jmansmann/ManualTransmissionTrainer/Manual Transmission Trainer/Manual Transmission Trainer Files/Hardware/image1.jpeg

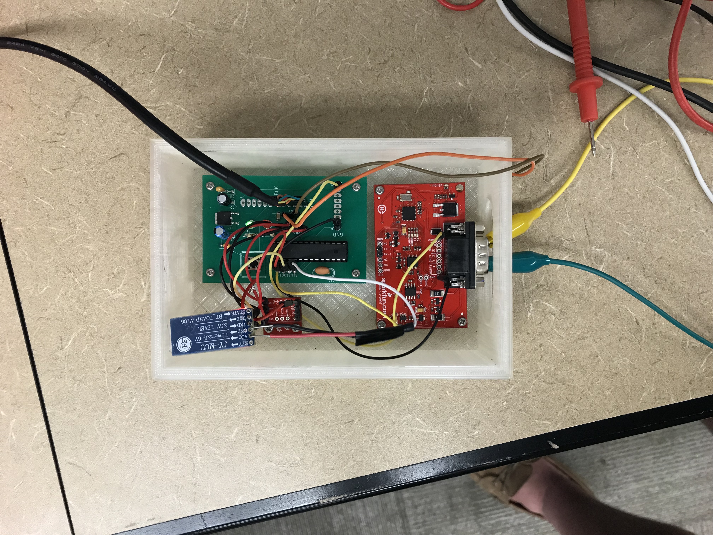
Manual Transmission Trainer/Manual Transmission Trainer Files/Hardware/image1.jpeg
