jmansmann/ManualTransmissionTrainer/Manual Transmission Trainer/Manual Transmission Trainer Files/Hardware/image2.jpeg

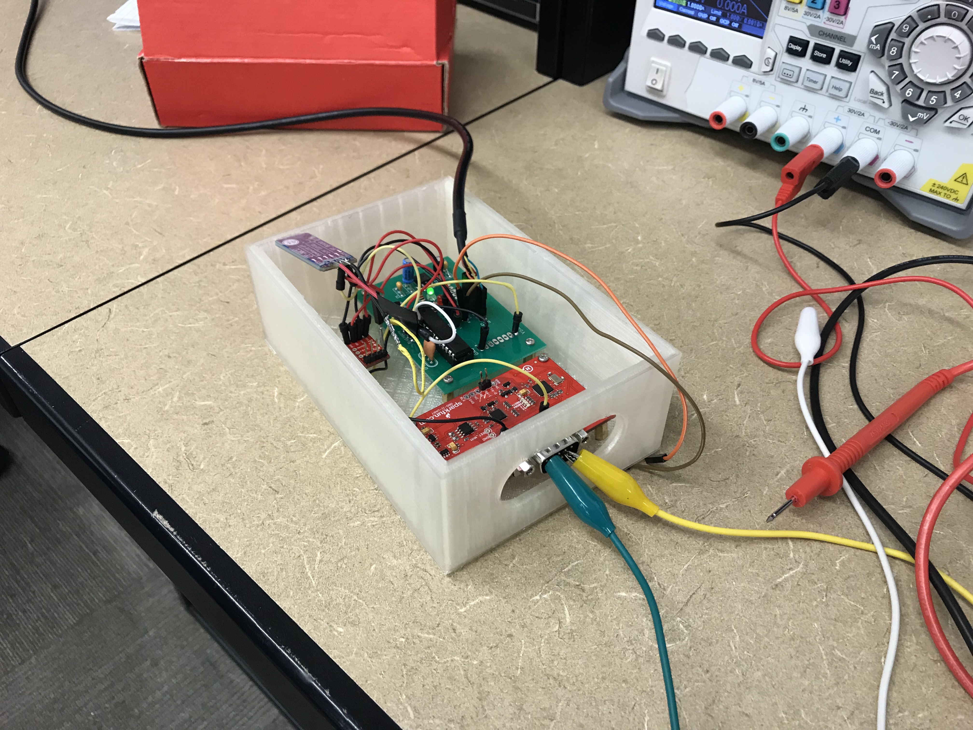
Manual Transmission Trainer/Manual Transmission Trainer Files/Hardware/image2.jpeg
