jmansmann/ManualTransmissionTrainer/Manual Transmission Trainer/Manual Transmission Trainer Files/Software/README.txt

Boarduino Read - Code associated with C++ application
Final_Arduino - Code associated with reading data from the microprocessor
Java - Source code for the entire Java application
Data - All types of the types of files that were used in testing and training the tree
