jmansmann/ManualTransmissionTrainer/Manual Transmission Trainer/Manual Transmission Trainer Files/Hardware/main_box.STL

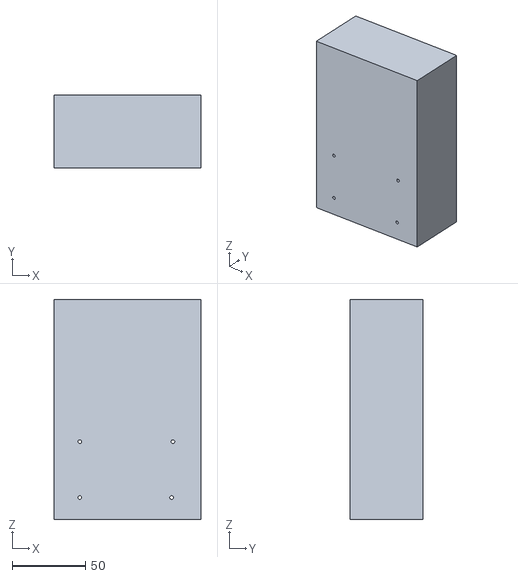
[picture p3: CAD file, 2019-01-07]
Manual Transmission Trainer/Manual Transmission Trainer Files/Hardware/main_box.STL
100.0 x 50.0 x 150.0
