jmansmann/ManualTransmissionTrainer/Manual Transmission Trainer/Manual Transmission Trainer Files/Hardware/mtt_housing_lid.STL

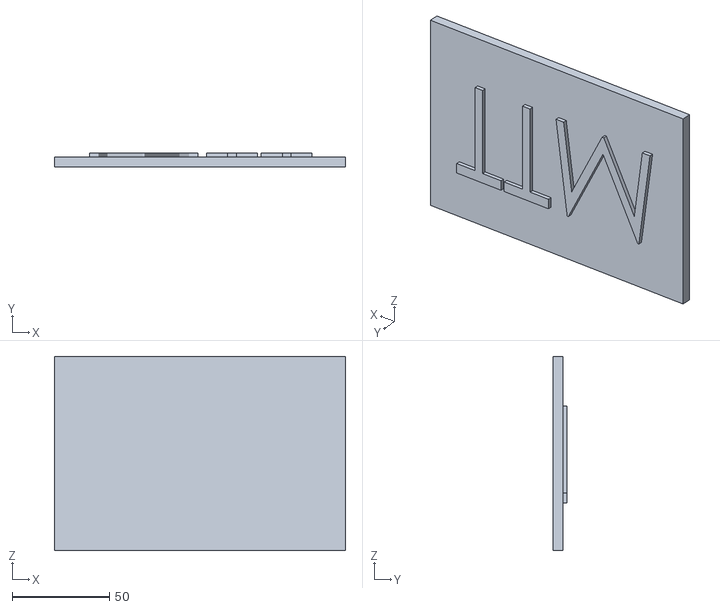
[picture p4: CAD file, 2019-01-07]
Manual Transmission Trainer/Manual Transmission Trainer Files/Hardware/mtt_housing_lid.STL
150.0 x 7.00 x 100.0
