jmansmann/ManualTransmissionTrainer/Manual Transmission Trainer/Manual Transmission Trainer Files/Software/Boarduino Read/README.txt

ArduinoRead.cpp  - Source C++ code to read from the bluetooth and commnicate with Java Program
BoarduinoRead.dev - Project File for the C++ console application
BoarduinoRead.exe - Exectable C++ console application
SerialPort.cpp - Sample Source code to real from a serial COM port
SerialPort.h - header file that goes with SerialPort.cpp
Makefile.win, BoarduinoRead.layout - default files that assist in project creation
*.o - object files
