jmansmann/ManualTransmissionTrainer/Manual Transmission Trainer/Manual Transmission Trainer Files/Software/Final_Arduino/README.txt

Final_Arduino  - Source code that reads data from car and sends that data over the Bluetooth
MPU9250.cpp - Code from internet used to operate MPU9250 gyroscope correctly
MPU9250.h - header file for MPU9250.cpp
quaternionFilters.cpp - Code from internet used to help operate the gyroscope
quaternionFilters.h - header file for quaternionFilters.cpp
