jmansmann/ManualTransmissionTrainer/Manual Transmission Trainer/Manual Transmission Trainer Files/Software/Data/6th_geaer_no_load.png

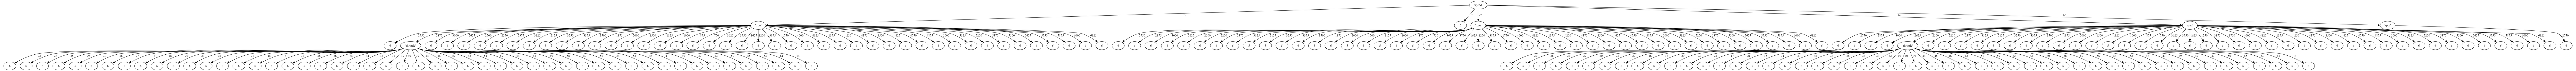
Manual Transmission Trainer/Manual Transmission Trainer Files/Software/Data/6th_geaer_no_load.png
