jmansmann/ManualTransmissionTrainer/Manual Transmission Trainer/Manual Transmission Trainer Files/Software/Data/6th_gear_tree.png

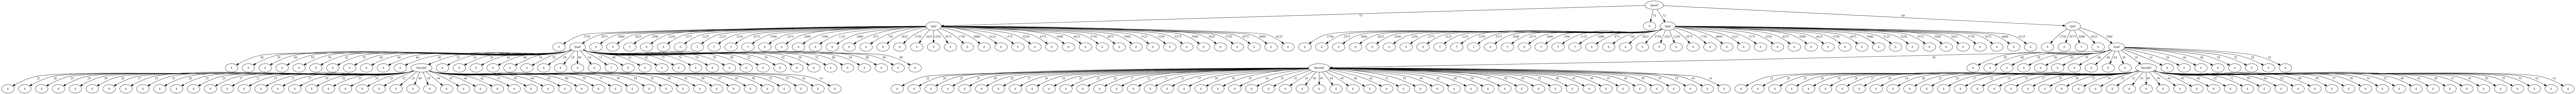
Manual Transmission Trainer/Manual Transmission Trainer Files/Software/Data/6th_gear_tree.png
