jmansmann/ManualTransmissionTrainer/Manual Transmission Trainer/Manual Transmission Trainer Files/Software/Data/OBDWiz files/First Gear/first_for_test.csv

# StartTime = 07/20/2018 02:20:26.3640 PM
Time (sec) | Vehicle speed (MPH) | Engine RPM (RPM) | Absolute throttle position (%) | Absolute load value (%) | MPH | RPM | Throttle | Load
0 | 0 | 0 | 0 | 0
0.06 | 0 | 2071 | 18.03922 | 0
0.126 | 10.56331 | 2071 | 18.03922 | 24.31373 | 12 | 2125 | 18 | 24
0.185 | 10.56331 | 2071 | 18.03922 | 24.31373 | 12 | 2125 | 18 | 24
0.251 | 10.56331 | 2102 | 18.03922 | 24.31373 | 12 | 2125 | 18 | 24
0.31 | 10.56331 | 2102 | 18.43137 | 24.70588 | 12 | 2125 | 18 | 24
0.375 | 10.56331 | 2102 | 18.43137 | 24.70588 | 12 | 2125 | 18 | 24
0.435 | 10.56331 | 2147 | 18.43137 | 24.70588 | 12 | 2125 | 18 | 24
0.503 | 10.56331 | 2147 | 18.43137 | 24.70588 | 12 | 2125 | 18 | 24
0.563 | 10.56331 | 2147 | 18.43137 | 24.70588 | 12 | 2125 | 18 | 24
0.623 | 10.56331 | 2147 | 18.43137 | 24.70588 | 12 | 2125 | 18 | 24
0.685 | 10.56331 | 2175 | 18.43137 | 24.70588 | 12 | 2125 | 18 | 24
0.753 | 10.56331 | 2175 | 18.43137 | 24.31373 | 12 | 2125 | 18 | 24
0.813 | 10.56331 | 2175 | 18.43137 | 24.31373 | 12 | 2125 | 18 | 24
0.873 | 10.56331 | 2228 | 18.43137 | 24.31373 | 12 | 2250 | 18 | 24
0.935 | 10.56331 | 2228 | 18.03922 | 23.13725 | 12 | 2250 | 18 | 24
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
