jmansmann/ManualTransmissionTrainer/Manual Transmission Trainer/Manual Transmission Trainer Files/Software/Data/OBDWiz files/Fourth Gear/fourth_for_test.csv

# StartTime = 08/01/2018 06:17:32.2497 PM
Time (sec) | Vehicle speed (MPH) | Engine RPM (RPM) | Absolute throttle position (%) | Absolute load value (%)
0 | 0 | 0 | 0 | 0
0.734 | 35.41816 | 1997 | 18.82353 | 50.58823
0.95 | 36.03953 | 2024 | 20.78431 | 28.62745
1.166 | 36.03953 | 2056 | 22.7451 | 40
1.373 | 36.6609 | 2089 | 21.96078 | 55.29412
1.582 | 37.28227 | 2107 | 21.96078 | 47.45098
1.794 | 37.90364 | 2146 | 21.96078 | 49.41177
2.018 | 38.52501 | 2183 | 21.56863 | 48.62745
2.234 | 39.14639 | 2192 | 16.47059 | 49.01961
2.458 | 39.14639 | 2219 | 16.07843 | 14.90196
2.67 | 39.76776 | 2231 | 14.90196 | 14.90196
2.891 | 39.76776 | 2220 | 15.29412 | 13.72549
3.107 | 40.38913 | 2242 | 15.29412 | 10.58823
3.33 | 39.76776 | 2254 | 15.29412 | 10.58823
3.542 | 40.38913 | 2264 | 15.29412 | 10.58823
3.762 | 40.38913 | 2263 | 17.64706 | 10.58823
3.979 | 40.38913 | 2298 | 17.2549 | 14.11765
4.203 | 40.38913 | 2271 | 16.07843 | 14.5098
4.415 | 40.38913 | 2276 | 15.68627 | 14.5098
4.635 | 40.38913 | 2285 | 16.47059 | 12.15686
4.851 | 41.0105 | 2290 | 18.03922 | 11.76471
5.067 | 41.0105 | 2304 | 18.43137 | 17.64706
5.267 | 41.0105 | 2302 | 14.90196 | 22.35294
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
