jmansmann/ManualTransmissionTrainer/Manual Transmission Trainer/Manual Transmission Trainer Files/Software/Data/OBDWiz files/Second Gear/second_for_test.csv

# StartTime = 07/20/2018 02:19:10.7379 PM
Time (sec) | Vehicle speed (MPH) | Engine RPM (RPM) | Absolute throttle position (%) | Absolute load value (%)
0 | 11.80605 | 0 | 0 | 0 | 12 | 0 | 0 | 0
0.062 | 11.80605 | 0 | 0 | 0 | 12 | 0 | 0 | 0
0.13 | 11.80605 | 0 | 0 | 0 | 12 | 0 | 0 | 0
0.186 | 11.80605 | 0 | 0 | 0 | 12 | 0 | 0 | 0
0.251 | 11.80605 | 0 | 0 | 0 | 12 | 0 | 0 | 0
0.311 | 11.80605 | 0 | 0 | 0 | 12 | 0 | 0 | 0
0.379 | 11.80605 | 0 | 0 | 0 | 12 | 0 | 0 | 0
0.439 | 11.80605 | 0 | 0 | 0 | 12 | 0 | 0 | 0
0.499 | 11.80605 | 0 | 0 | 0 | 12 | 0 | 0 | 0
0.562 | 11.80605 | 0 | 0 | 0 | 12 | 0 | 0 | 0
0.63 | 11.80605 | 0 | 0 | 0 | 12 | 0 | 0 | 0
0.689 | 11.80605 | 0 | 0 | 0 | 12 | 0 | 0 | 0
0.75 | 12.42742 | 1556 | 24.31373 | 77.25491 | 12 | 1500 | 24 | 78
0.813 | 14.91291 | 1556 | 24.31373 | 77.25491 | 15 | 1500 | 24 | 78
0.874 | 14.91291 | 1556 | 24.31373 | 77.25491 | 15 | 1500 | 24 | 78
0.937 | 14.91291 | 1729 | 26.27451 | 77.25491 | 15 | 1750 | 26 | 78
1.001 | 15.53428 | 1729 | 26.27451 | 67.84314 | 15 | 1750 | 26 | 68
1.061 | 15.53428 | 1729 | 26.27451 | 67.84314 | 15 | 1750 | 26 | 68
1.129 | 15.53428 | 1831 | 26.66667 | 67.84314 | 15 | 1875 | 27 | 68
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
