jmansmann/ManualTransmissionTrainer/Manual Transmission Trainer/Manual Transmission Trainer Files/Software/Data/OBDWiz files/Sixth Gear/sixth_for_test.csv

# StartTime = 07/20/2018 02:01:32.8629 PM
Time (sec) | Vehicle speed (MPH) | Engine RPM (RPM) | Absolute throttle position (%) | Absolute load value (%) | MPH | RPM | Throttle | Load
0 | 0 | 2467 | 0 | 0
0.064 | 0 | 2467 | 22.35294 | 45.88235
0.125 | 65.86535 | 2467 | 22.35294 | 45.88235 | 66 | 2500 | 22 | 46
0.186 | 65.86535 | 2471 | 22.35294 | 45.88235 | 66 | 2500 | 22 | 46
0.254 | 65.86535 | 2471 | 22.35294 | 45.4902 | 66 | 2500 | 22 | 46
0.314 | 65.86535 | 2471 | 22.35294 | 45.4902 | 66 | 2500 | 22 | 46
0.375 | 65.86535 | 2471 | 22.35294 | 45.4902 | 66 | 2500 | 22 | 46
0.436 | 65.86535 | 2477 | 22.35294 | 45.4902 | 66 | 2500 | 22 | 46
0.504 | 65.86535 | 2477 | 22.35294 | 46.66667 | 66 | 2500 | 22 | 46
0.563 | 65.86535 | 2477 | 22.35294 | 46.66667 | 66 | 2500 | 22 | 46
0.623 | 65.86535 | 2481 | 22.35294 | 46.66667 | 66 | 2500 | 22 | 46
0.686 | 65.86535 | 2481 | 21.56863 | 45.4902 | 66 | 2500 | 22 | 46
0.754 | 65.86535 | 2481 | 21.56863 | 45.4902 | 66 | 2500 | 22 | 46
0.814 | 65.86535 | 2481 | 21.56863 | 45.4902 | 66 | 2500 | 22 | 46
0.874 | 65.86535 | 2486 | 20.39216 | 45.4902 | 66 | 2500 | 20 | 46
0.937 | 66.48672 | 2486 | 20.39216 | 34.5098 | 66 | 2500 | 20 | 34
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
