jmansmann/ManualTransmissionTrainer/Manual Transmission Trainer/Manual Transmission Trainer Files/Software/Data/OBDWiz files/Third Gear/third_for_test.csv

# StartTime = 08/01/2018 06:14:46.4162 PM
Time (sec) | Vehicle speed (MPH) | Engine RPM (RPM) | Absolute throttle position (%) | Absolute load value (%)
0 | 21.74799 | 1669 | 19.60784 | 0
0.212 | 22.36936 | 1683 | 19.60784 | 42.35294
0.424 | 22.36936 | 1700 | 19.60784 | 42.35294
0.636 | 22.99073 | 1714 | 19.60784 | 41.96078
0.852 | 22.99073 | 1731 | 20 | 42.7451
1.072 | 22.99073 | 1762 | 26.66667 | 67.45098
1.288 | 24.23348 | 1799 | 27.05882 | 67.45098
1.504 | 24.23348 | 1837 | 27.05882 | 69.01961
1.717 | 24.85485 | 1878 | 27.45098 | 69.01961
1.936 | 25.47622 | 1915 | 27.45098 | 69.41177
2.141 | 25.47622 | 1943 | 27.45098 | 68.62745
2.349 | 26.09759 | 1978 | 27.45098 | 69.80392
2.559 | 26.71896 | 2024 | 27.45098 | 70.58823
2.783 | 27.34033 | 2070 | 27.45098 | 67.84314
3.003 | 27.9617 | 2105 | 27.84314 | 69.01961
3.223 | 28.58307 | 2150 | 27.84314 | 69.41177
3.439 | 29.20445 | 2191 | 27.84314 | 69.80392
3.643 | 29.20445 | 2233 | 27.84314 | 70.19608
3.855 | 29.82582 | 2266 | 27.45098 | 69.01961
4.071 | 30.44719 | 2292 | 27.05882 | 66.27451
4.287 | 31.06856 | 2323 | 26.27451 | 66.66666
4.503 | 31.68993 | 2363 | 25.4902 | 66.27451
4.719 | 31.68993 | 2404 | 25.4902 | 62.7451
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
