jmansmann/ManualTransmissionTrainer/Manual Transmission Trainer/Manual Transmission Trainer Files/Software/Data/real-time test files/RealDataScreenShot.PNG

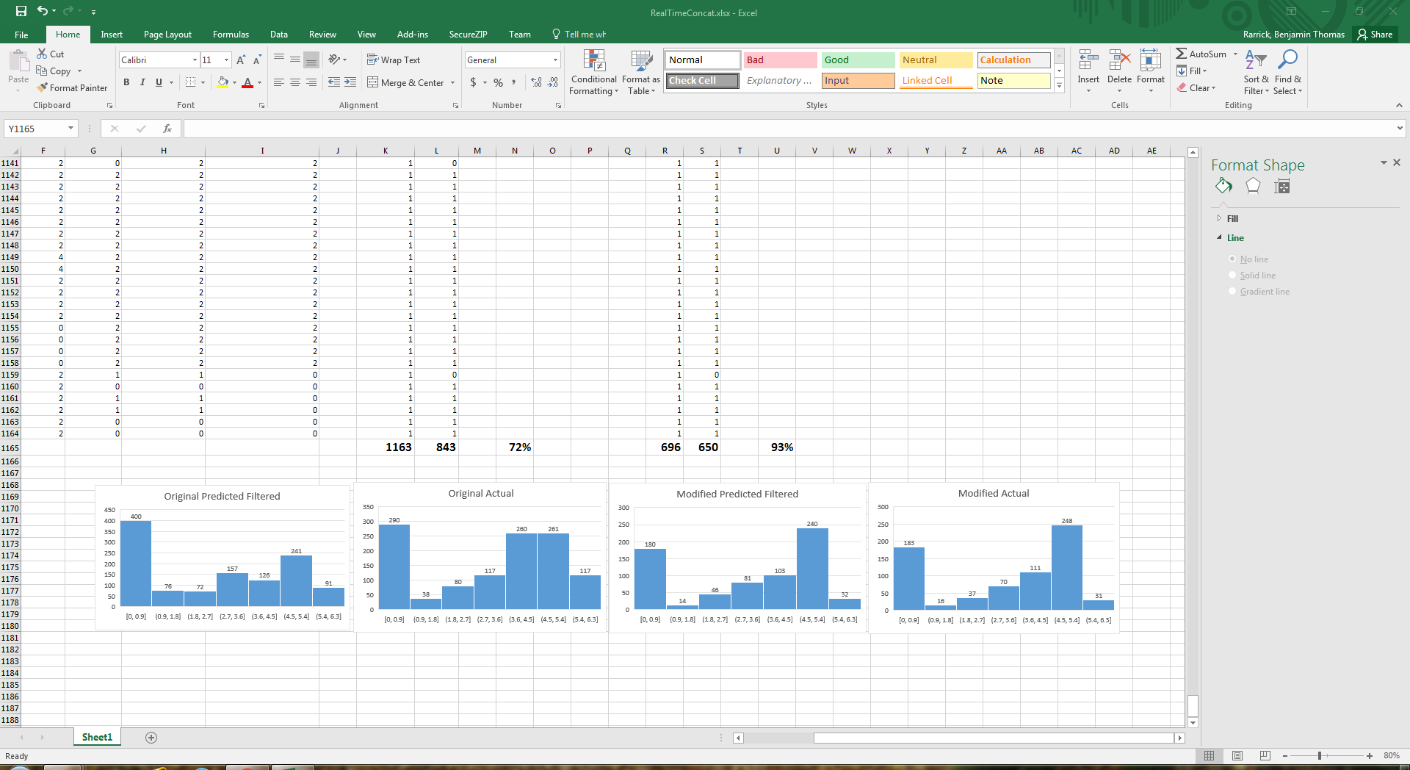
Manual Transmission Trainer/Manual Transmission Trainer Files/Software/Data/real-time test files/RealDataScreenShot.PNG
