jmansmann/ManualTransmissionTrainer/Manual Transmission Trainer/Manual Transmission Trainer Files/Hardware/PCB.brd

## EAGLE design Manual Transmission Trainer/Manual Transmission Trainer Files/Hardware/PCB.brd (2019-01-07)

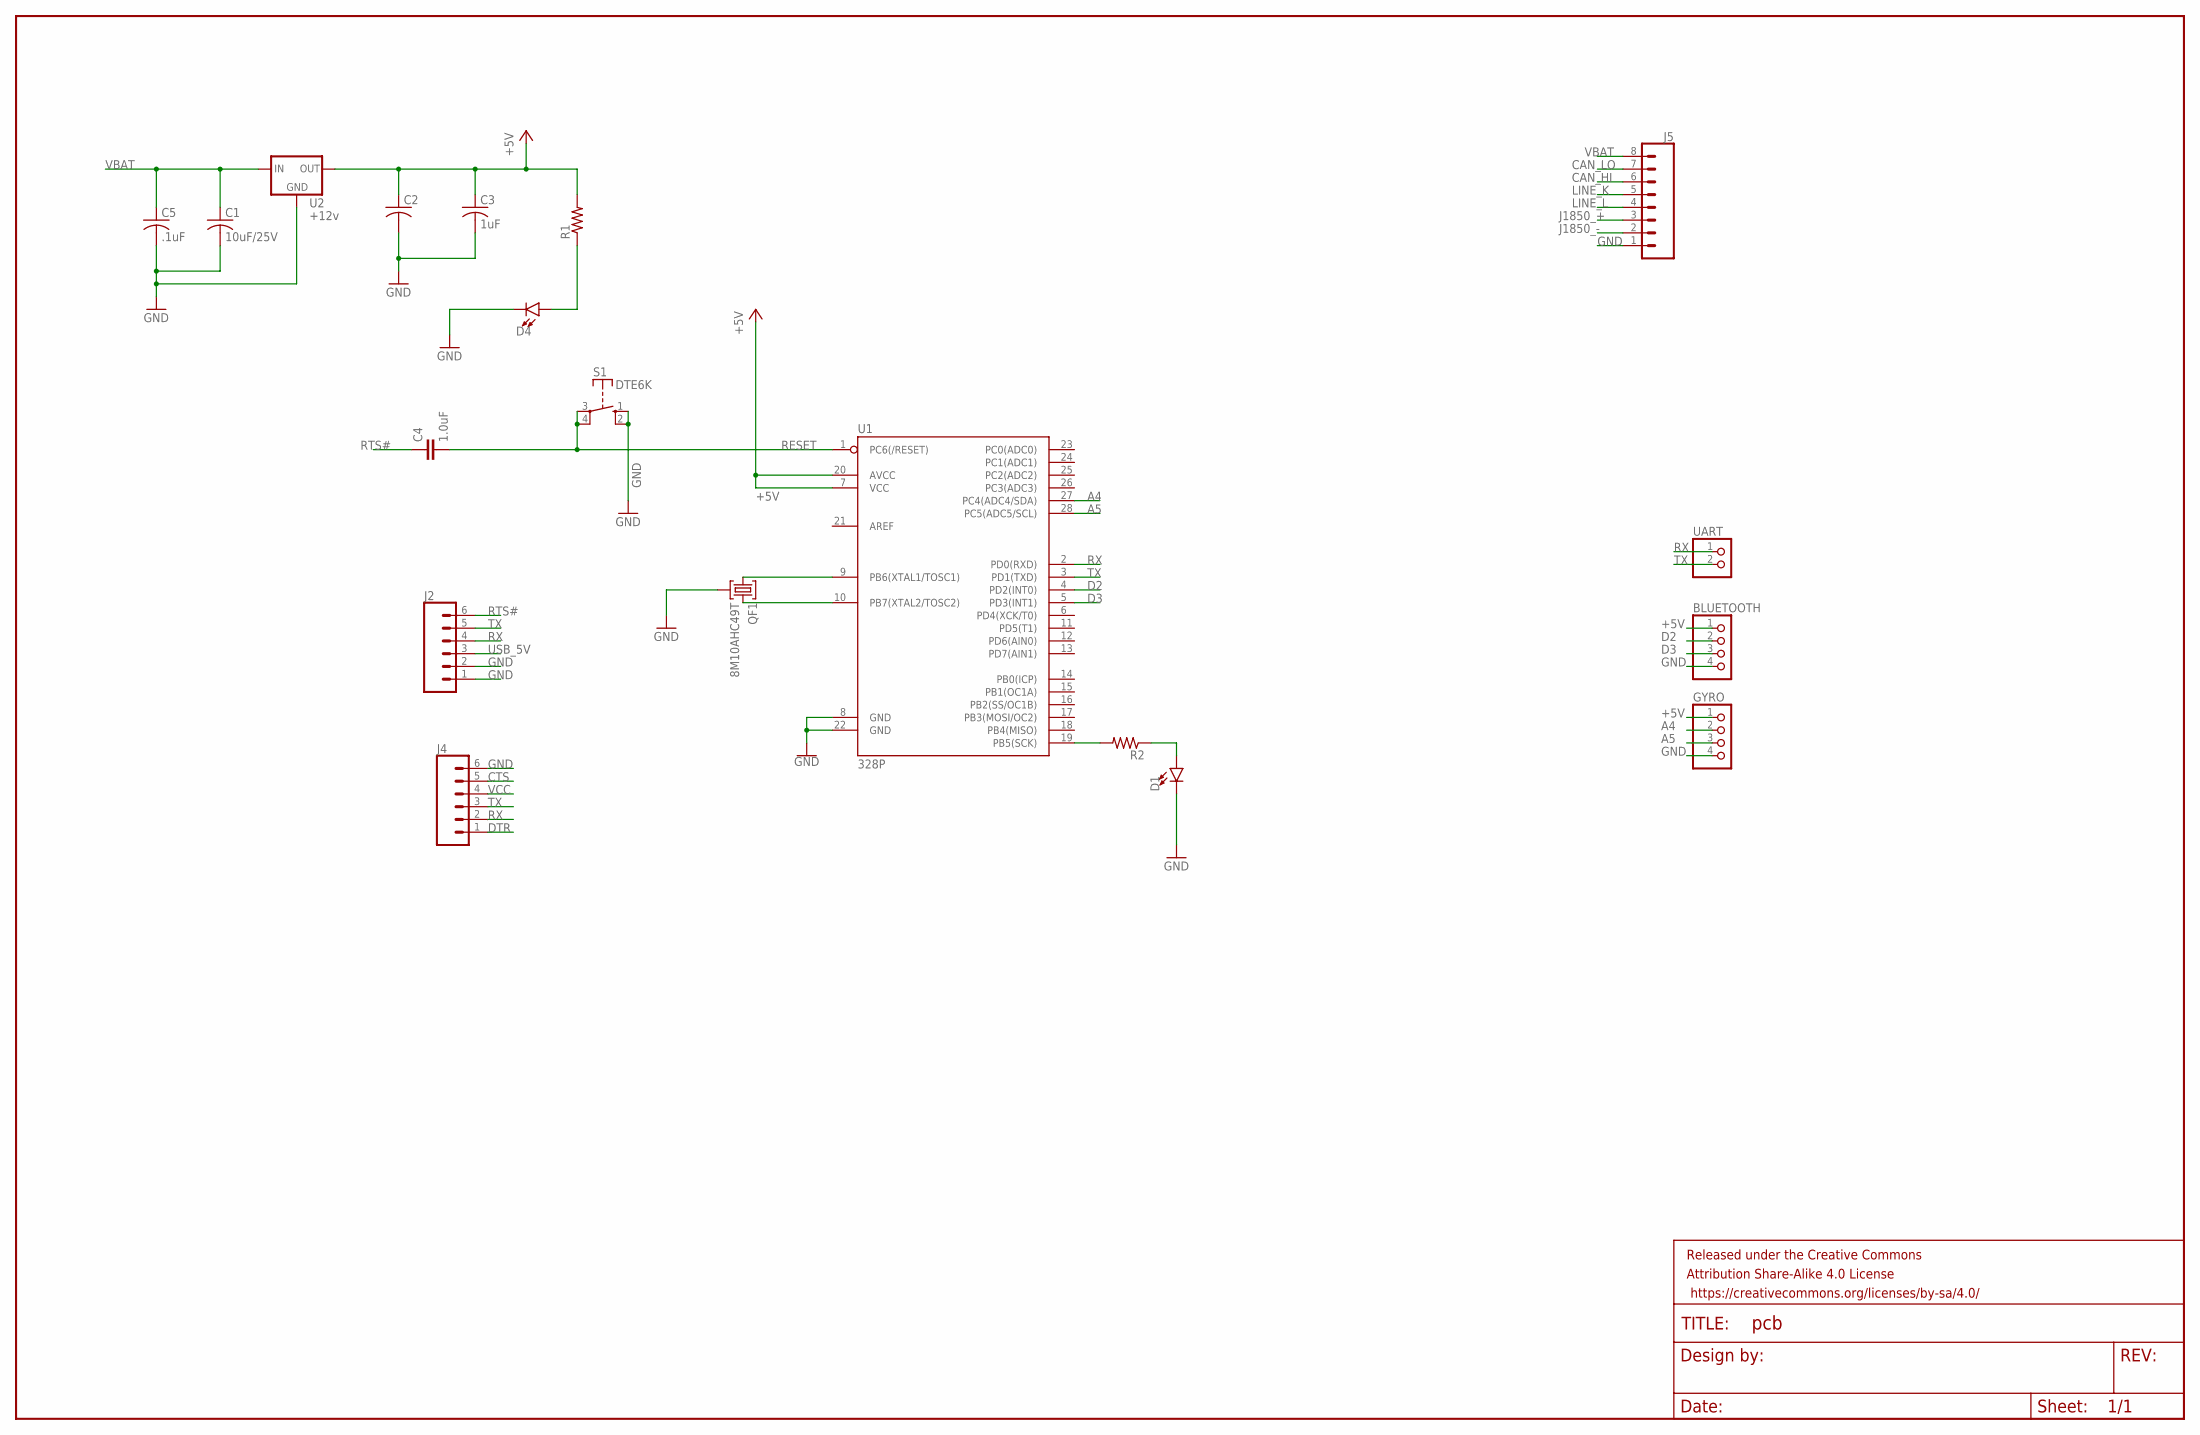
[picture p25: schematic PCB.sch]

Parts:
BLUETOOTH: PINHD-1X4; 1X04
C1: 10uF/25V; C050-025X075
C2: C-US050-025X075; C050-025X075
C3: 1uF; C050-025X075
C4: 1.0uF; 1206
C5: .1uF; C050-025X075
D1, D4: LED3MM; LED_3MM
FRAME1: FRAME-LEDGER; CREATIVE_COMMONS
GYRO: PINHD-1X4; 1X04
J2, J4: CONN_06LONGPADS; 1X06_LONGPADS
J5: CONN_08LONGPADS; 1X08_LONGPADS
QF1: 8M10AHC49T; HC49U
R1, R2: R-US_0204/5; 0204/5
S1: DTE6K
U1: 328P; DIP28
U2: +12v; TO-252
UART: PINHD-1X2; 1X02

Connections:
+5V: BLUETOOTH.1, C2.1, C3.1, GYRO.1, R1.2, U1.7 (VCC), U1.20 (AVCC), U2.2 (OUT)
A4: GYRO.2, U1.27 (PC4(ADC4/SDA))
A5: GYRO.3, U1.28 (PC5(ADC5/SCL))
CAN_HI: J5.6
CAN_LO: J5.7
CTS: J4.5
D2: BLUETOOTH.2, U1.4 (PD2(INT0))
D3: BLUETOOTH.3, U1.5 (PD3(INT1))
DTR: J4.1
GND: BLUETOOTH.4, C1.2, C2.2, C3.2, C5.2, D1.K (C), D4.K (C), GYRO.4, J2.1, J2.2, J4.6, J5.1, QF1.2, S1.1 (S), S1.2 (S), U1.8 (GND), U1.22 (GND), U2.3 (GND)
J1850_+: J5.3
J1850_-: J5.2
LINE_K: J5.5
LINE_L: J5.4
unnamed: QF1.1, U1.9 (PB6(XTAL1/TOSC1))
unnamed: QF1.3, U1.10 (PB7(XTAL2/TOSC2))
unnamed: R2.2, U1.19 (PB5(SCK))
unnamed: D1.A, R2.1
unnamed: D4.A, R1.1
RESET: C4.2, S1.3, S1.4, U1.1 (PC6(/RESET))
RTS#: C4.1, J2.6
RX: J2.4, J4.2, U1.2 (PD0(RXD)), UART.1
TX: J2.5, J4.3, U1.3 (PD1(TXD)), UART.2
USB_5V: J2.3
VBAT: C1.1, C5.1, J5.8, U2.1 (IN)
VCC: J4.4

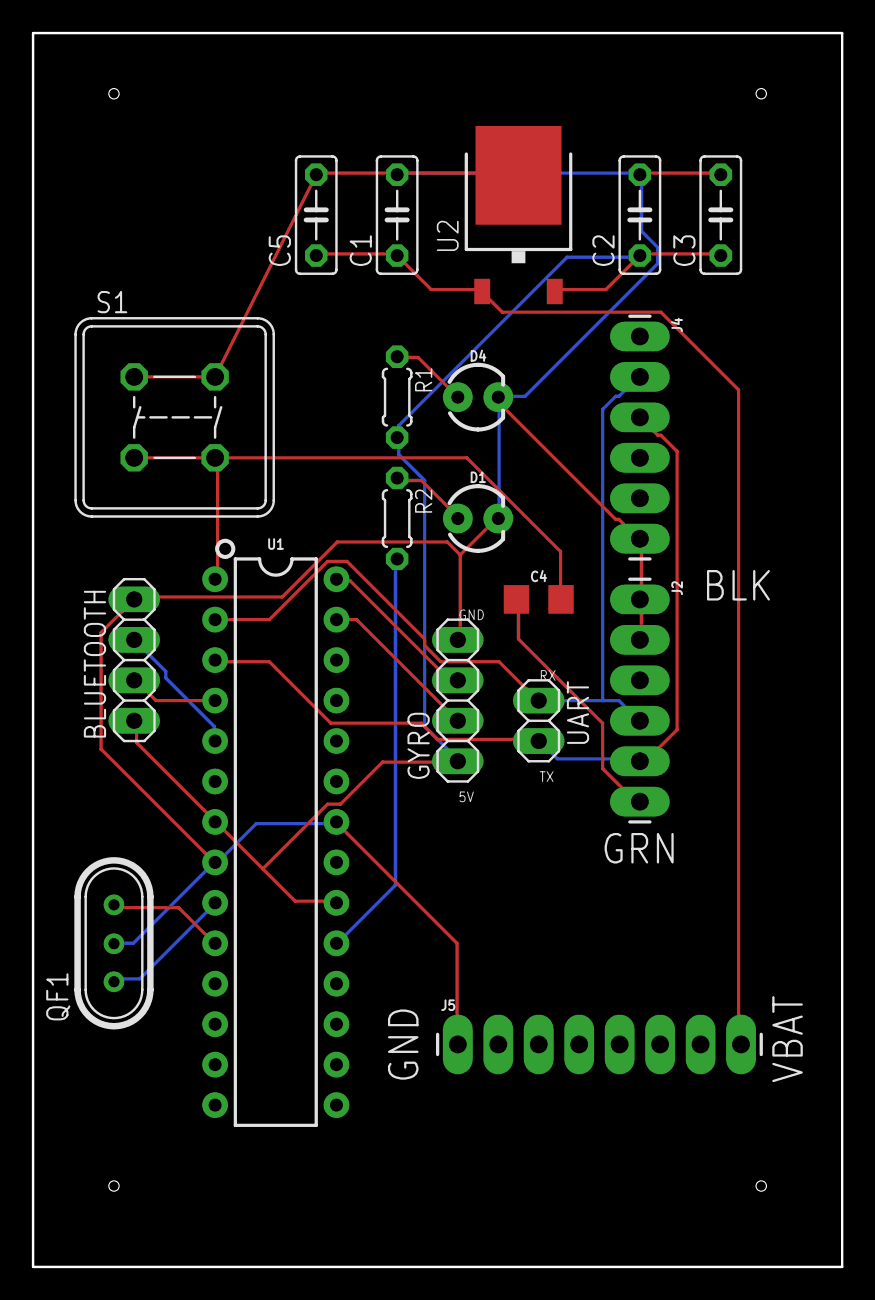
[picture p26: board PCB.brd from above]

Board: 2 copper layers, 50.8 x 77.5 mm, 20 parts (0 on the bottom side), 16 nets.
